uchile-robotics-graveyard/uchile_embedded/bender_head_arduino/README.md

Contenido del package
---------------------

[TOC]

# Software Interface

# Hardware Interface

# TODO LIST

## TODO list Hardware
* Implementar colores rgb en Arduino en lugar de en la interfaz de software
* Implementar comportamientos (funciones) determinados en Arduino
	+Agregar funciones "rainbow", "theaterChaseRainbow", etc.
	+Agregar "swap de servos"
* Probar con los brazos funcionando
* Solucionar problema con puertos seriales que usan los brazos
## TODO list Software
* Eliminar dependencias a directorio local al pasar a repo bender_head (rama feat-head\_arduino)
* Implementar nodo para control mediante joystick
* Implementar Archivos de configuracion para las caras
