uchile-robotics-graveyard/uchile_embedded/head_boards_http/design/num_leds_rgb.pdf

LED-> | 1 | 2 | 3 | 4 | 5 | 6 | 7 | 8 | 9 | 10 | 11 | 12 | 13 | 14 | 15 | 16
R | 95 | 92 | 89 | 86 | 83 | 80 | 77 | 74 | 71 | 68 | 65 | 62 | 59 | 56 | 53 | 50
G | 94 | 91 | 88 | 85 | 82 | 79 | 76 | 73 | 70 | 67 | 64 | 61 | 58 | 55 | 52 | 49
B | 93 | 90 | 87 | 84 | 81 | 78 | 75 | 72 | 69 | 66 | 63 | 60 | 57 | 54 | 51 | 48
LED-> 32 | 31 | 30 | 29 | 28 | 27 | 26 | 25 | 24 | 23 | 22 | 21 | 20 | 19 | 18 | 17
R | 2 | 5 | 8 | 11 | 14 | 17 | 20 | 23 | 26 | 29 | 32 | 35 | 38 | 41 | 44 | 47
G | 1 | 4 | 7 | 10 | 13 | 16 | 19 | 22 | 25 | 28 | 31 | 34 | 37 | 40 | 43 | 46
B | 0 | 3 | 6 | 9 | 12 | 15 | 18 | 21 | 24 | 27 | 30 | 33 | 36 | 39 | 42 | 45

*simetricos verticalmente

http://www.rapidtables.com/web/color/RGB_Color.htm
