uchile-robotics-graveyard/uchile_embedded/head_boards_http/design/mascara bender2.png

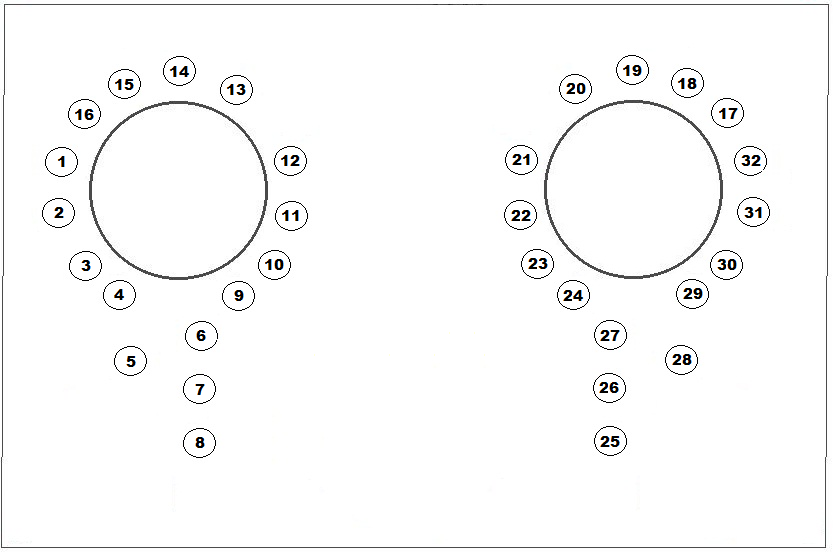
head_boards_http/design/mascara bender2.png
