uchile-robotics-graveyard/uchile_embedded/(list of files, cad)

Other CAD files:
head_led_driver/dist/default/production/head_led_driver.X.production.obj
head_led_driver/l.obj
