uchile-robotics-graveyard/uchile_embedded/head_boards_http/eagle/bender_head/servo_driver_board.brd

## EAGLE design head_boards_http/eagle/bender_head/servo_driver_board.brd (2016-02-21)

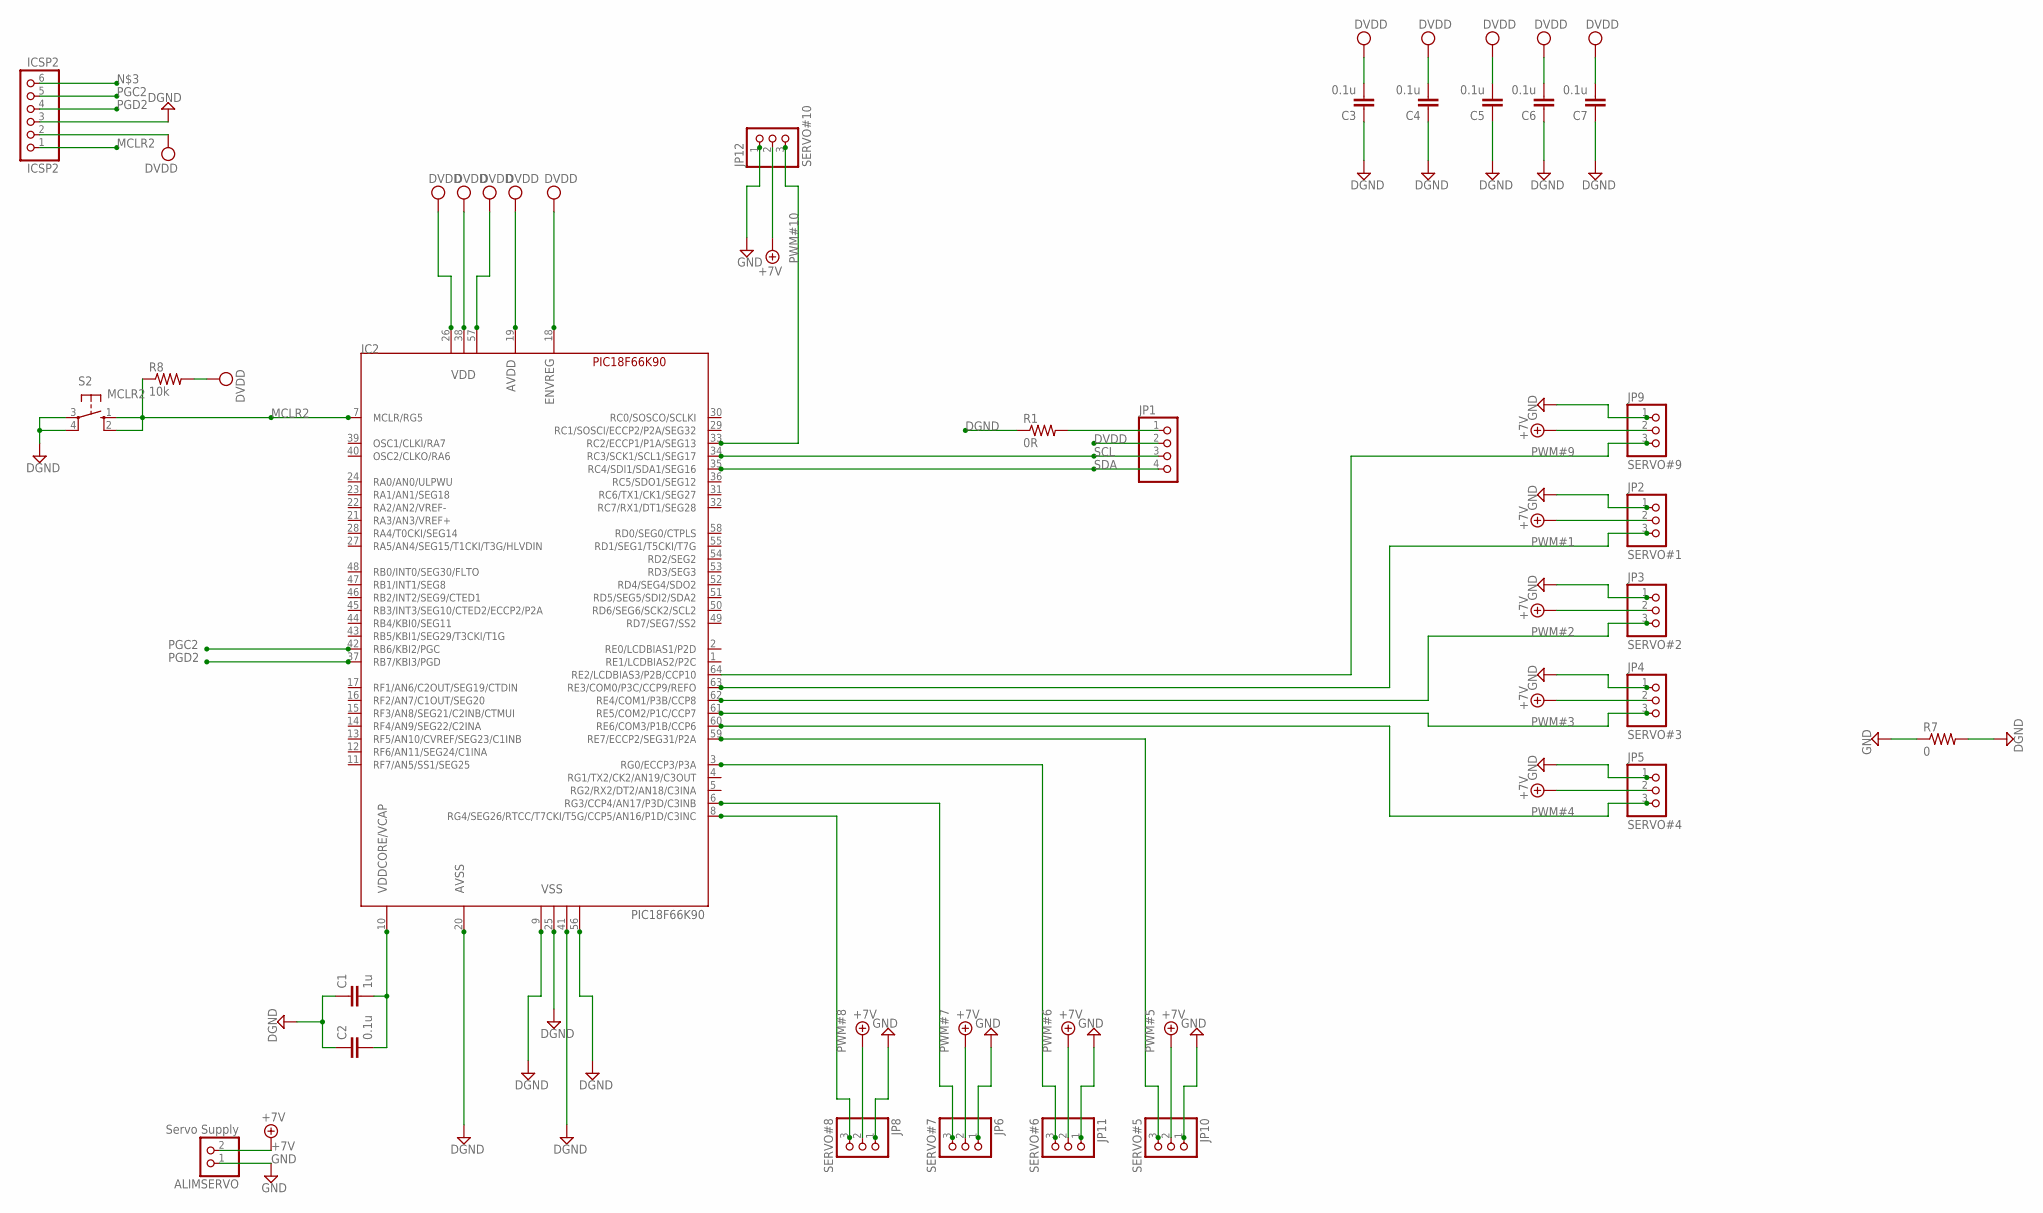
[picture p2: schematic servo_driver_board.sch]

Parts:
ALIMSERVO: Servo Supply; 1X02
C1: 1u; C0805
C2, C3, C4, C5, C6, C7: 0.1u; C0805
IC2: PIC18F66K90; TQFP64-10X10
ICSP2: ICSP2; 1X06
JP1: PINHD-1X4/90; 1X04/90
JP2: SERVO#1; 1X03
JP3: SERVO#2; 1X03
JP4: SERVO#3; 1X03
JP5: SERVO#4; 1X03
JP6: SERVO#7; 1X03
JP8: SERVO#8; 1X03
JP9: SERVO#9; 1X03
JP10: SERVO#5; 1X03
JP11: SERVO#6; 1X03
JP12: SERVO#10; 1X03
R1: 0R; R1206
R7: 0; R1206
R8: 10k; R1206
S2: MCLR2; B3F-10XX

Connections:
+7V: ALIMSERVO.2, JP2.2, JP3.2, JP4.2, JP5.2, JP6.2, JP8.2, JP9.2, JP10.2, JP11.2, JP12.2
DGND: C1.1, C2.1, C3.1, C4.1, C5.1, C6.1, C7.1, IC2.9 (VSS), IC2.20 (AVSS), IC2.25 (VSS), IC2.41 (VSS), IC2.56 (VSS), ICSP2.3, R1.1, R7.2, S2.3, S2.4 (P1)
DVDD: C3.2, C4.2, C5.2, C6.2, C7.2, IC2.18 (ENVREG), IC2.19 (AVDD), IC2.26 (VDD), IC2.38 (VDD), IC2.57 (VDD), ICSP2.2, JP1.2, R8.2
GND: ALIMSERVO.1, JP2.1, JP3.1, JP4.1, JP5.1, JP6.1, JP8.1, JP9.1, JP10.1, JP11.1, JP12.1, R7.1
MCLR2: IC2.7 (MCLR/RG5), ICSP2.1, R8.1, S2.1 (S), S2.2 (S1)
unnamed: JP1.1, R1.2
unnamed: C1.2, C2.2, IC2.10 (VDDCORE/VCAP)
PGC2: IC2.42 (RB6/KBI2/PGC), ICSP2.5
PGD2: IC2.37 (RB7/KBI3/PGD), ICSP2.4
PWM#1: IC2.63 (RE3/COM0/P3C/CCP9/REFO), JP2.3
PWM#2: IC2.62 (RE4/COM1/P3B/CCP8), JP3.3
PWM#3: IC2.61 (RE5/COM2/P1C/CCP7), JP4.3
PWM#4: IC2.60 (RE6/COM3/P1B/CCP6), JP5.3
PWM#5: IC2.59 (RE7/ECCP2/SEG31/P2A), JP10.3
PWM#6: IC2.3 (RG0/ECCP3/P3A), JP11.3
PWM#7: IC2.6 (RG3/CCP4/AN17/P3D/C3INB), JP6.3
PWM#8: IC2.8 (RG4/SEG26/RTCC/T7CKI/T5G/CCP5/AN16/P1D/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), JP8.3
PWM#9: IC2.64 (RE2/LCDBIAS3/P2B/CCP10), JP9.3
PWM#10: IC2.33 (RC2/ECCP1/P1A/SEG13), JP12.3
SCL: IC2.34 (RC3/SCK1/SCL1/SEG17), JP1.3
SDA: IC2.35 (RC4/SDI1/SDA1/SEG16), JP1.4

Notes on the sheet:
PWM#1
PWM#2
PWM#3
PWM#4
PWM#7
PWM#8
PWM#9
PWM#5
PWM#6
PWM#10

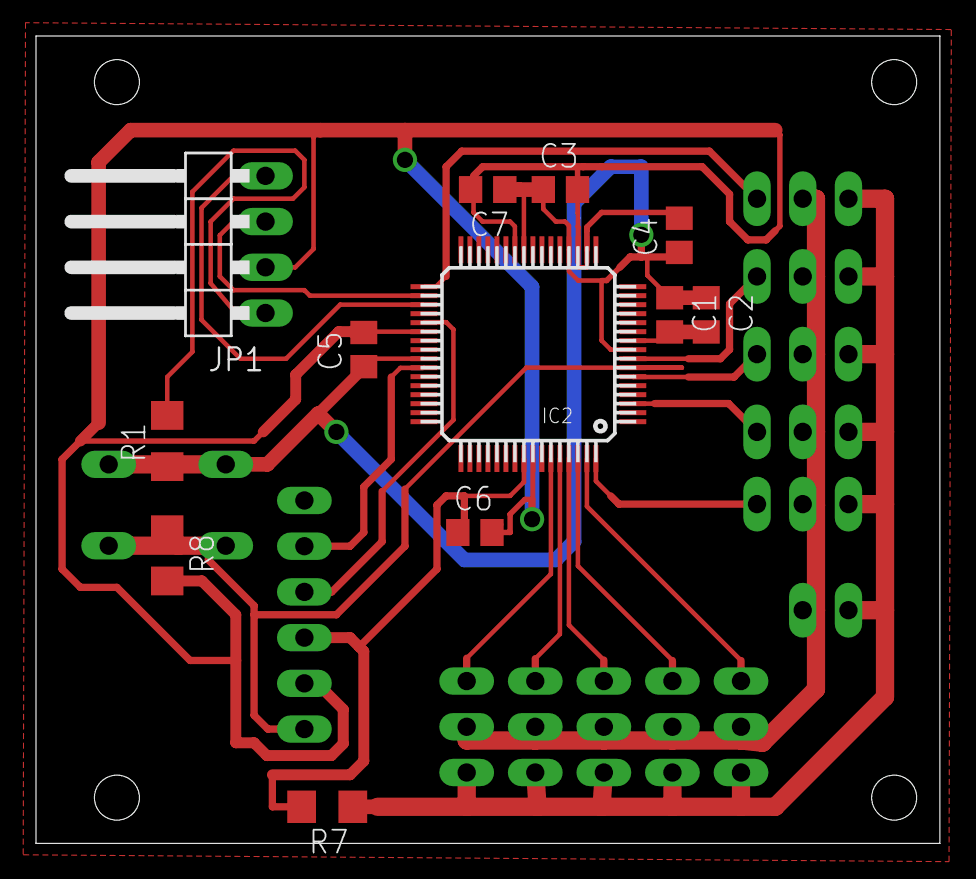
[picture p3: board servo_driver_board.brd from above]

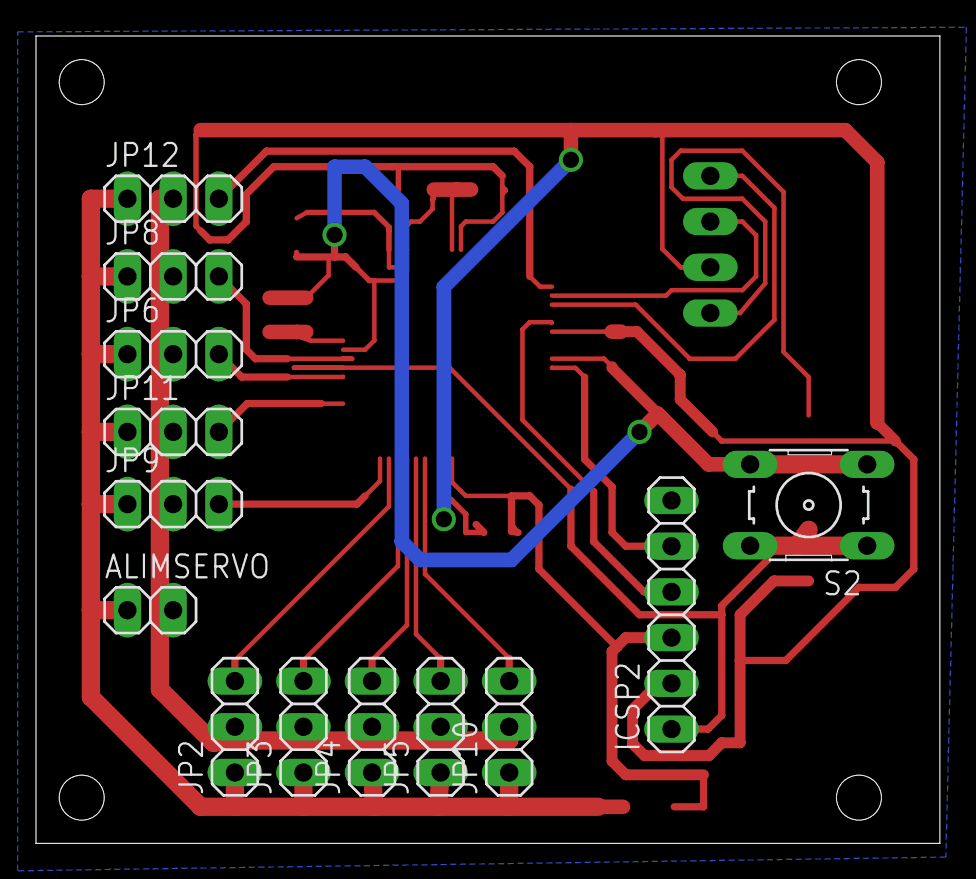
[picture p4: board servo_driver_board.brd from below]

Board: 2 copper layers, 50.2 x 44.9 mm, 25 parts (13 on the bottom side), 21 nets.
