uchile-robotics-graveyard/uchile_embedded/head_boards_http/eagle/bender_head/bender_head.brd

## EAGLE design head_boards_http/eagle/bender_head/bender_head.brd (2016-02-21)

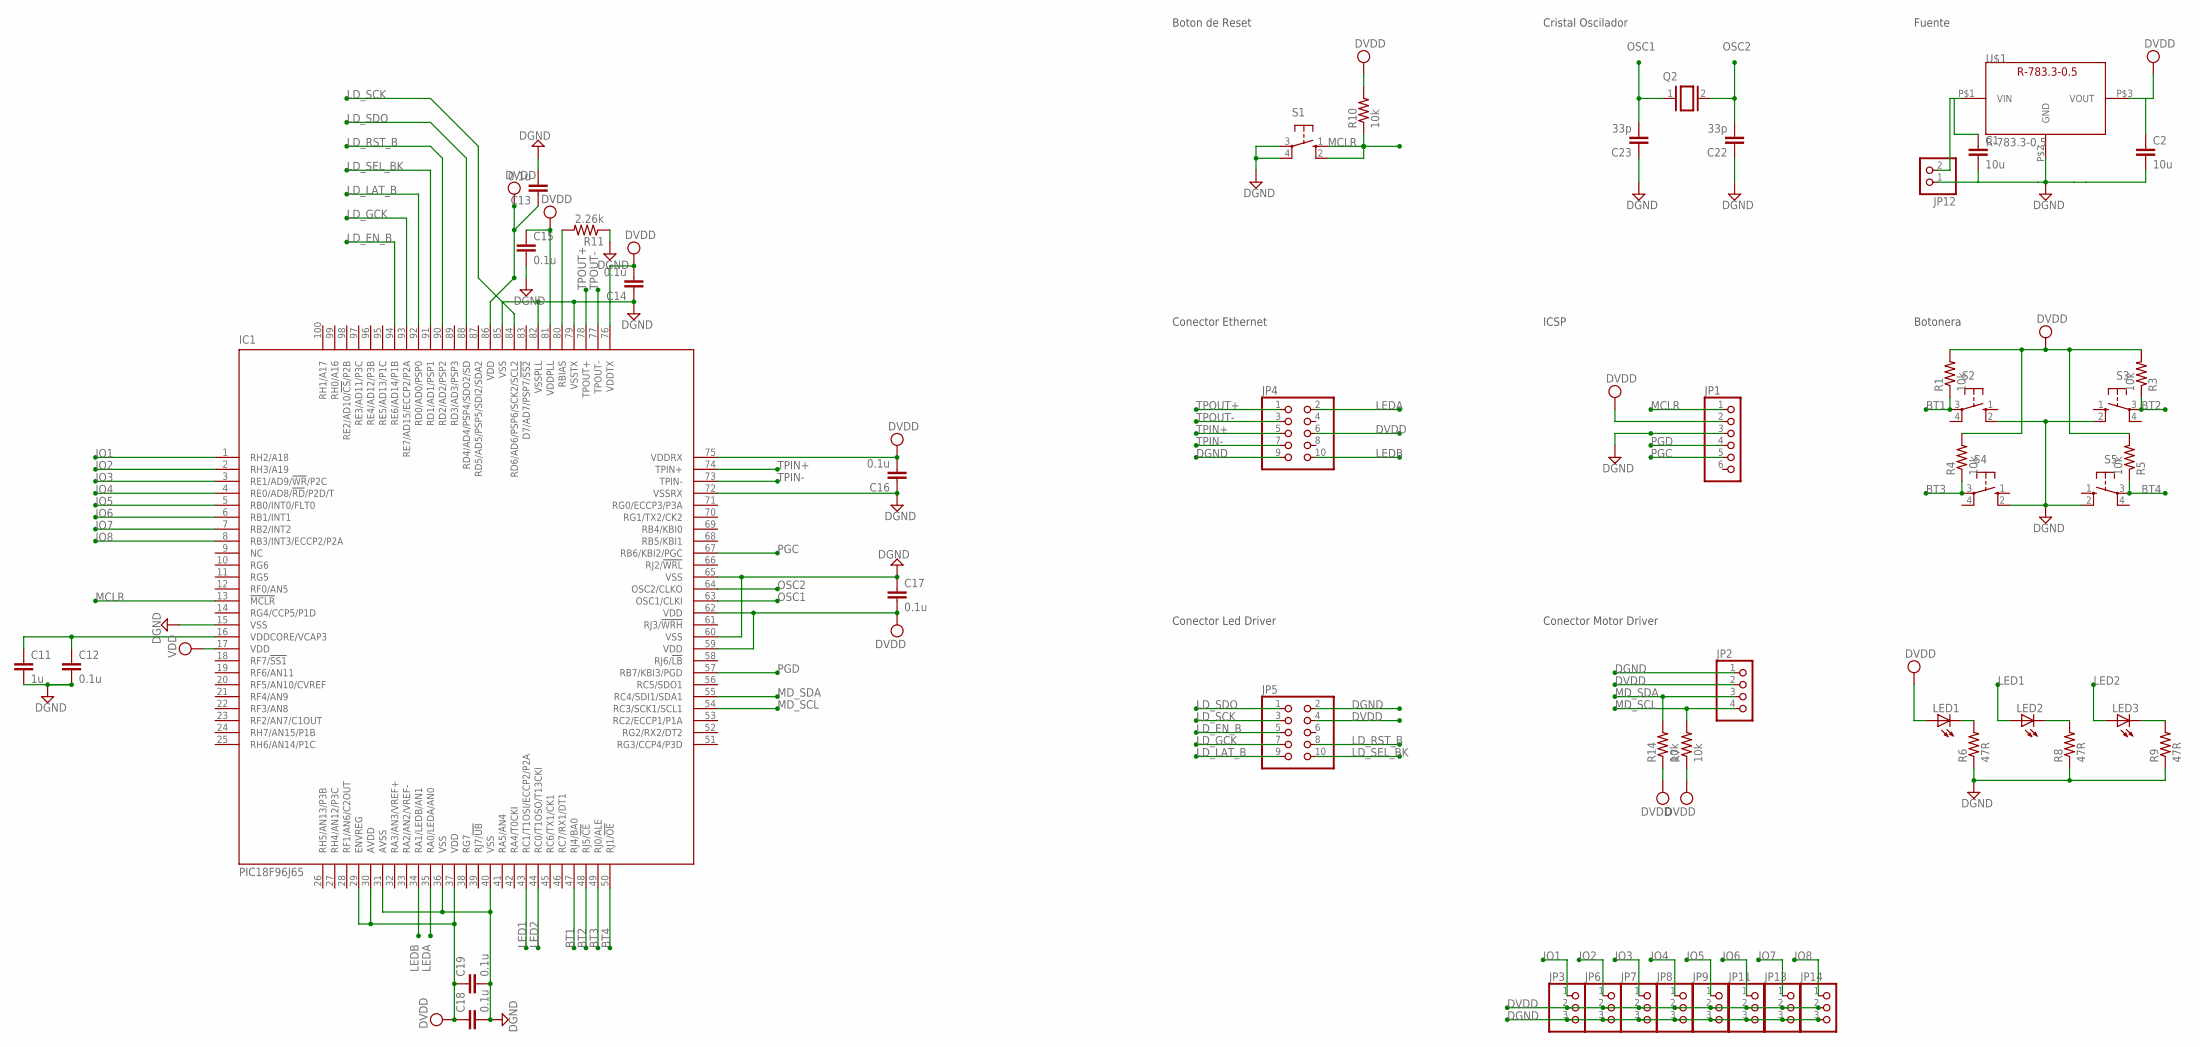
[picture p5: schematic bender_head.sch]

Parts:
C1, C2: 10u; C1206
C11: 1u; C1206
C12, C13, C14, C15, C16, C17, C18, C19: 0.1u; C0805
C22, C23: 33p; C1206
IC1: PIC18F96J65; TQFP100
JP1: PINHD-1X6; 1X06
JP2: PINHD-1X4/90; 1X04/90
JP3, JP6, JP7, JP8, JP9, JP11, JP13, JP14: PINHD-1X3; 1X03
JP4, JP5: PINHD-2X5/90; 2X05/90
JP12: PINHD-1X2/90; 1X02/90
LED1, LED2, LED3: LEDSML0805; SML0805
Q2: XTAL/S; QS
R1, R3, R4, R5, R7, R10, R14: 10k; R1206
R6: 47R; M0805
R8, R9: 47R; M1206
R11: 2.26k; R1206
S1, S2, S3, S4, S5: 10-XX; B3F-10XX
U$1: R-783.3-0.5

Connections:
BT1: IC1.47 (RJ4/BA0), R1.1, S2.3
BT2: IC1.48 (RJ5/!CE), R3.1, S3.3
BT3: IC1.49 (RJ0/ALE), R4.1, S4.3
BT4: IC1.50 (RJ1/!OE), R5.1, S5.3
DGND: C1.2, C2.2, C11.2, C12.2, C13.2, C14.1, C15.2, C16.1, C17.1, C18.2, C19.2, C22.1, C23.1, IC1.15 (VSS), IC1.31 (AVSS), IC1.36 (VSS), IC1.40 (VSS), IC1.60 (VSS), IC1.65 (VSS), IC1.72 (VSSRX), IC1.79 (VSSTX), IC1.82 (VSSPLL), IC1.85 (VSS), JP1.3, JP2.1, JP3.3, JP4.9, JP5.2, JP6.3, JP7.3, JP8.3, JP9.3, JP11.3, JP12.1, JP13.3, JP14.3, R6.1, R8.1, R9.1, R11.1, S1.3, S1.4 (P1), S2.2 (S1), S3.2 (S1), S4.2 (S1), S5.2 (S1), U$1.P$2 (GND)
DVDD: C2.1, C13.1, C14.2, C15.1, C16.2, C17.2, C18.1, C19.1, IC1.17 (VDD), IC1.29 (ENVREG), IC1.30 (AVDD), IC1.37 (VDD), IC1.59 (VDD), IC1.62 (VDD), IC1.75 (VDDRX), IC1.76 (VDDTX), IC1.81 (VDDPLL), IC1.86 (VDD), JP1.2, JP2.2, JP3.2, JP4.6, JP5.4, JP6.2, JP7.2, JP8.2, JP9.2, JP11.2, JP13.2, JP14.2, LED1.A, R1.2, R3.2, R4.2, R5.2, R7.1, R10.2, R14.1, U$1.P$3 (VOUT)
IO1: IC1.1 (RH2/A18), JP3.1
IO2: IC1.2 (RH3/A19), JP6.1
IO3: IC1.3 (RE1/AD9/!WR!/P2C), JP7.1
IO4: IC1.4 (RE0/AD8/!RD!/P2D/T), JP8.1
IO5: IC1.5 (RB0/INT0/FLT0), JP9.1
IO6: IC1.6 (RB1/INT1), JP11.1
IO7: IC1.7 (RB2/INT2), JP13.1
IO8: IC1.8 (RB3/INT3/ECCP2/P2A), JP14.1
LD_EN_B: IC1.94 (RE6/AD14/P1B), JP5.5
LD_GCK: IC1.93 (RE7/AD15/ECCP2/P2A), JP5.7
LD_LAT_B: IC1.92 (RD0/AD0/PSP0), JP5.9
LD_RST_B: IC1.90 (RD2/AD2/PSP2), JP5.8
LD_SCK: IC1.84 (RD6/AD6/PSP6/SCK2/SCL2), JP5.3
LD_SDO: IC1.88 (RD4/AD4/PSP4/SDO2/SD), JP5.1
LD_SEL_BK: IC1.91 (RD1/AD1/PSP1), JP5.10
LED1: IC1.43 (RC1/T1OSI/ECCP2/P2A), LED2.A
LED2: IC1.44 (RC0/T1OSO/T13CKI), LED3.A
LEDA: IC1.35 (RA0/LEDA/AN0), JP4.2
LEDB: IC1.34 (RA1/LEDB/AN1), JP4.10
MCLR: IC1.13 (!MCLR), JP1.1, R10.1, S1.1 (S), S1.2 (S1)
MD_SCL: IC1.54 (RC3/SCK1/SCL1), JP2.4, R7.2
MD_SDA: IC1.55 (RC4/SDI1/SDA1), JP2.3, R14.2
unnamed: LED1.C, R6.2
unnamed: LED2.C, R8.2
unnamed: LED3.C, R9.2
unnamed: C11.1, C12.1, IC1.16 (VDDCORE/VCAP3)
unnamed: IC1.80 (RBIAS), R11.2
OSC1: C23.2, IC1.63 (OSC1/CLKI), Q2.1
OSC2: C22.2, IC1.64 (OSC2/CLKO), Q2.2
PGC: IC1.67 (RB6/KBI2/PGC), JP1.5
PGD: IC1.57 (RB7/KBI3/PGD), JP1.4
TPIN+: IC1.74 (TPIN+), JP4.5
TPIN-: IC1.73 (TPIN-), JP4.7
TPOUT+: IC1.78 (TPOUT+), JP4.1
TPOUT-: IC1.77 (TPOUT-), JP4.3
VIN: C1.1, JP12.2, U$1.P$1 (VIN)

Notes on the sheet:
Conector Ethernet
Cristal Oscilador
Boton de Reset
Conector Led Driver
Conector Motor Driver
ICSP
Botonera
Fuente

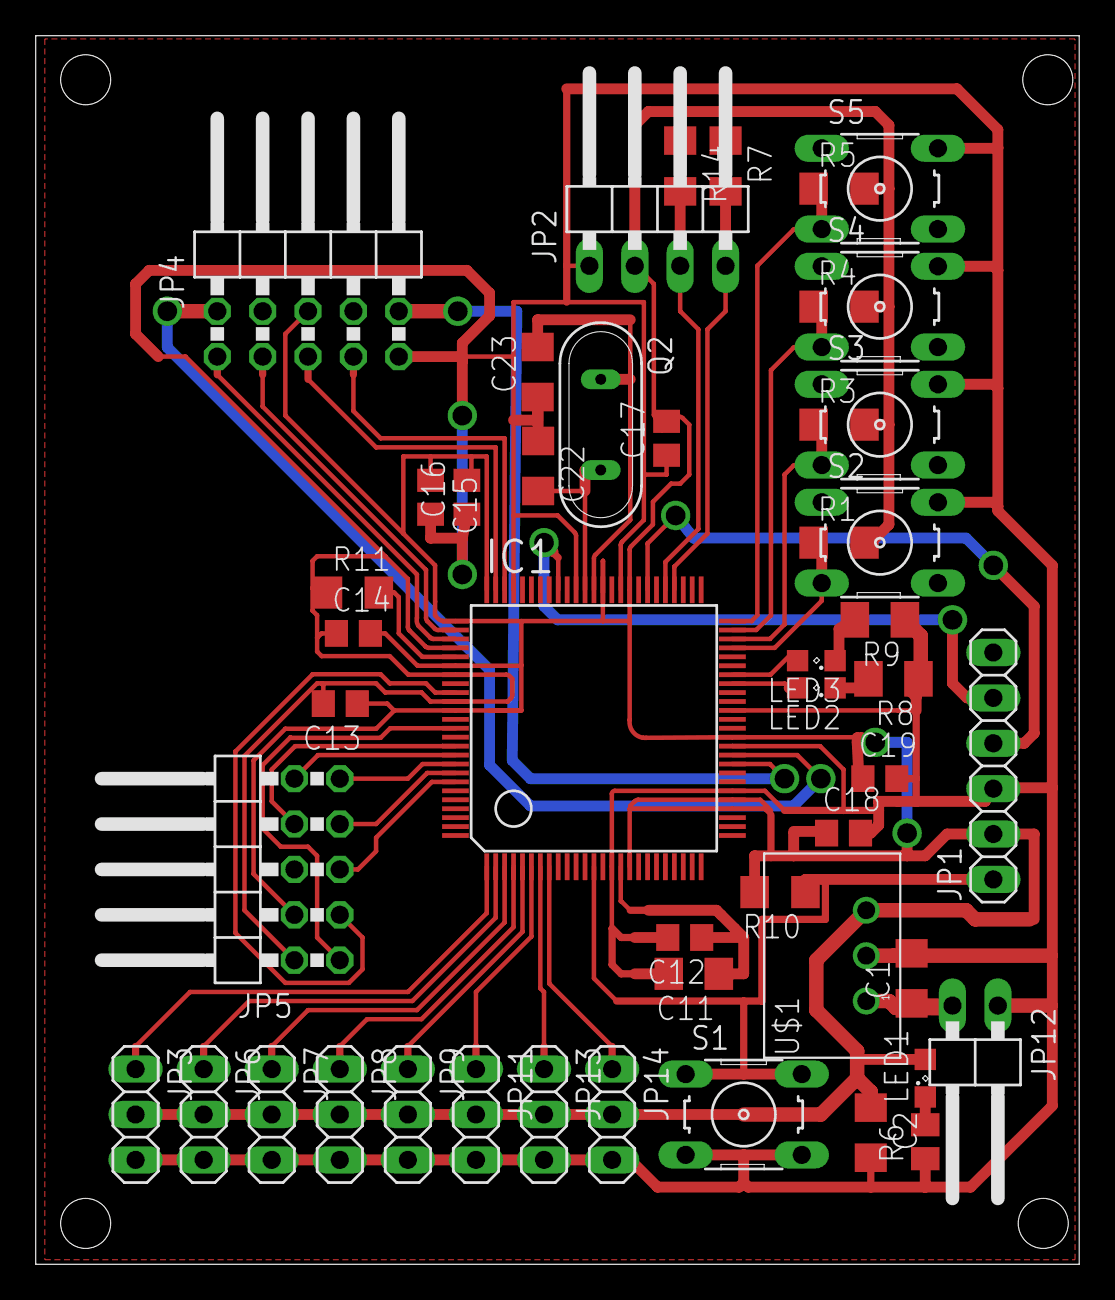
[picture p6: board bender_head.brd from above]

Board: 2 copper layers, 58.4 x 68.8 mm, 48 parts (0 on the bottom side), 42 nets.
