uchile-robotics-graveyard/uchile_embedded/head_boards_http/eagle/bender_head/ethernet_board.brd

## EAGLE design head_boards_http/eagle/bender_head/ethernet_board.brd (2016-02-21)

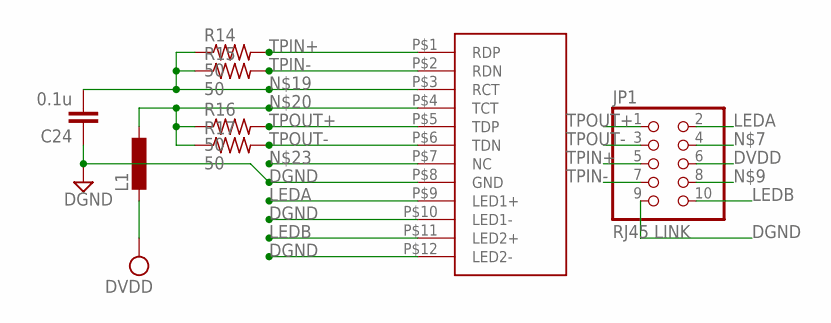
[picture p7: schematic ethernet_board.sch]

Parts:
C24: 0.1u; C0805
JP1: RJ45 LINK; 2X05/90
L1: L-EU0207/10; 0207/10
R14, R15, R16, R17: 50; R1206
U$5: RJ45; TYCO-RJ45

Connections:
DGND: C24.1, JP1.9, U$5.P$8 (GND), U$5.P$10 (LED1-), U$5.P$12 (LED2-)
DVDD: JP1.6, L1.2
LEDA: JP1.2, U$5.P$9 (LED1+)
LEDB: JP1.10, U$5.P$11 (LED2+)
unnamed: C24.2, R14.1, R15.1, U$5.P$3 (RCT)
unnamed: L1.1, R16.1, R17.1, U$5.P$4 (TCT)
TPIN+: JP1.5, R14.2, U$5.P$1 (RDP)
TPIN-: JP1.7, R15.2, U$5.P$2 (RDN)
TPOUT+: JP1.1, R16.2, U$5.P$5 (TDP)
TPOUT-: JP1.3, R17.2, U$5.P$6 (TDN)

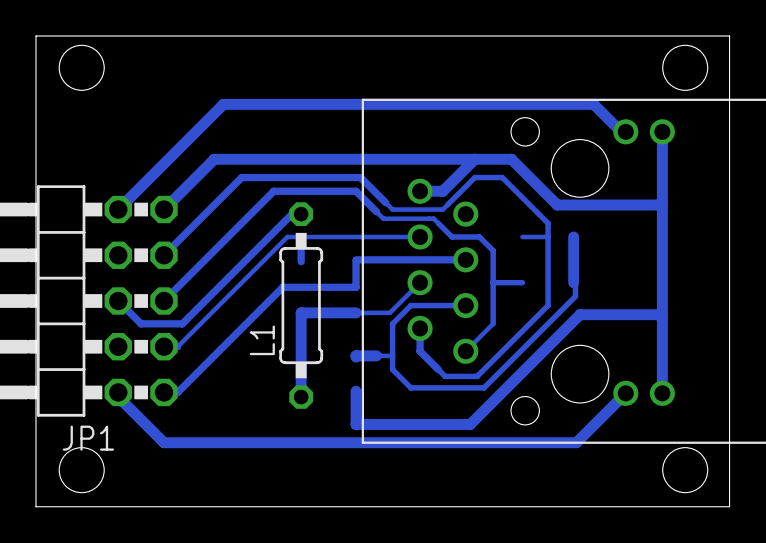
[picture p8: board ethernet_board.brd from above]

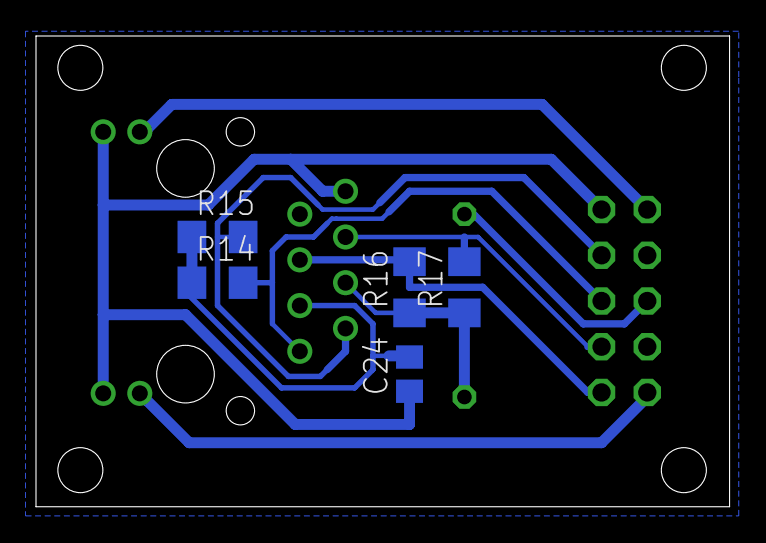
[picture p9: board ethernet_board.brd from below]

Board: 2 copper layers, 38.5 x 26.2 mm, 8 parts (5 on the bottom side), 10 nets.
