uchile-robotics-graveyard/uchile_embedded/bender_head_arduino/arduino/head_driver_fix/head_driver_fix.ino

#include <SerialDXL.h>
#include <Servo.h>
#include <Adafruit_NeoPixel.h>
#ifdef __AVR__
  #include <avr/power.h>
#endif

// SERVO DXL basic config
#define HEAD_MODEL 100
#define HEAD_FIRMWARE 100
#define HEAD_MMAP_SIZE 4

// Number of servos in the array
#define num_servos 5

// Pin numbers on Arduino Mega to control the servo devices
#define pin_dir 6
#define pin_reset 7
#define pin_servo0 8
#define pin_servo1 9
#define pin_servo2 10
#define pin_servo3 11
#define pin_servo4 12

// Pin numbers on Arduino Mega to control the LED devices
#define data_led_pin1 3
#define data_led_pin2 2
#define pixelNumber 16

/**
 * @brief Head control using DXL communication protocol
 * @details Head control using Dynamixel communication protocol over RS485.
 * This implementation uses 4 uint8_t variables to control state of 5 servo motors and 2 NeoPixel arrays. 
 * 
 * @param dir_pin Toggle communication pin.
 * @param reset_pin Pin for reset device
 * @param servo_pin SERVO pin.
 */
class HeadDXL: public DeviceDXL<HEAD_MODEL, HEAD_FIRMWARE>
{
  public:
	HeadDXL(uint8_t dir_pin, uint8_t reset_pin, uint8_t numServos, uint8_t servos_pins[]):
    DeviceDXL(HEAD_MMAP_SIZE), // Call parent constructor
    dir_pin_(dir_pin),    // Direction pin for RS485
    reset_pin_(reset_pin), // Reset pin
	  numServos_(numServos), // numero de servos
	  //servos_pins_(servos_pins),    // SERVOS pins
	  //servos_(servos),			// Puntero a objeto Servo
    servo_select_command_(MMap::Access::RW, MMap::Storage::RAM), // Servo command 1
    servo_pos_command_(MMap::Access::RW, MMap::Storage::RAM), // Servo command 2
	  led_select_command_(MMap::Access::RW, MMap::Storage::RAM), // array LEDs command 1
	  led_color_command_(MMap::Access::RW, MMap::Storage::RAM) // array LEDs command 2
    //led_update_color_command_(LED_UPDATE_COLOR_COMMAND, MMap::Access::RW, 0U, 1U, 0U) // array LEDs command 3
    {
      // Config pins
      pinMode(dir_pin_, OUTPUT);
      pinMode(reset_pin_, OUTPUT);
  	  for(uint8_t i=0;i<numServos_;i++)
  	  {
        pinMode(servos_pins[i], OUTPUT);
  	  }
    }

    void init(uint8_t servos_pins[], Servo servos[], Adafruit_NeoPixel LEDs[])
    {
      DEBUG_PRINTLN("INIT");
      /*
       * Register variables
       */
      DeviceDXL::init();
      mmap_.registerVariable(&servo_select_command_);
      mmap_.registerVariable(&servo_pos_command_);
      mmap_.registerVariable(&led_select_command_);
      mmap_.registerVariable(&led_color_command_);
      //mmap_.registerVariable(&led_update_color_command_);
      mmap_.init();
      
      /*
       * Load default values
       */
      DEBUG_PRINTLN("Load default");
      mmap_.load(); // Load values from EEPROM
      DEBUG_PRINT("data: ");DEBUG_PRINTLN(servo_select_command_.data);
      DEBUG_PRINT("data: ");DEBUG_PRINTLN(servo_pos_command_.data);
      DEBUG_PRINT("data: ");DEBUG_PRINTLN(led_select_command_.data);
      DEBUG_PRINT("data: ");DEBUG_PRINTLN(led_color_command_.data);
      // DEBUG_PRINT("data: ");DEBUG_PRINTLN(led_update_color_command_.data);
      
      /*
       * Read sensor data
       * e.g. Use ADC, check buttons, etc.
       */

  	  /*
  	   * Attach the Servo's variables to the servos_pins
  	   */
  	  for(uint8_t i=0;i<numServos_;i++)
  	  {
  	  	servos[i].attach(servos_pins[i]);
  	  }
        // Settings for LED arrays
  	  // This is for Trinket 5V 16MHz, you can remove these three lines if you are not using a Trinket
  	  #if defined (__AVR_ATtiny85__)
  		if (F_CPU == 16000000) clock_prescale_set(clock_div_1);
  	  #endif
  	  // End of trinket special code
      for(uint8_t i=0;i<2;i++)
  	  {
  	  	LEDs[i].begin();
  	    LEDs[i].setBrightness(5);
  	    LEDs[i].show(); // Initialize all pixels to 'off'
  	  }
    }
  
  	void moveServoTo(Servo *servo, uint8_t pos)
  	{
  		servo->write(pos);
  		delay(2);
  	}
 
  	void setPixelsTo(Adafruit_NeoPixel *LEDs_ring1, Adafruit_NeoPixel *LEDs_ring2, uint8_t R_colors[], uint8_t G_colors[], uint8_t B_colors[], uint8_t size)
  	{
  		//Serial.println(sizeof(pixelPositions));
  		for(uint8_t i=0; i<size; i++)
  		{
  			LEDs_ring1->setPixelColor(i, R_colors[i], G_colors[i], B_colors[i]);
  			LEDs_ring2->setPixelColor(i, R_colors[i+16], G_colors[i+16], B_colors[i+16]);
  		}
  		LEDs_ring1->show();
  		delay(5);
  		LEDs_ring2->show();
  		delay(5);
  		DEBUG_PRINTLN("LEDs_rings->show()");
  	}
 
  	uint8_t colorLevel(uint8_t level_code)
  	{
  		if(level_code==0) return 0;	//min component color value
  		else if(level_code==1) return 102;
  		else if(level_code==2) return 153;
  		else if(level_code==3) return 255;	//max component color value
  	}
 
  	uint8_t getRColor(uint8_t rgb_code){ return colorLevel((rgb_code & 0b00110000)>>4);}
  	uint8_t getGColor(uint8_t rgb_code){ return colorLevel((rgb_code & 0b00001100)>>2);}
  	uint8_t getBColor(uint8_t rgb_code){ return colorLevel((rgb_code & 0b00000011)>>0);}

  	//void updateServos(Servo servos[], uint8_t servo_select, uint8_t servo_pos, uint8_t command)
  	void updateServos(Servo servos[])
  	{
  		if (servo_select_command_.data == 5)	//when both values updated, change state
  		{
  			if (servo_select_ == 0) moveServoTo(&servos[0], servo_pos_);
  			else if (servo_select_ == 1) moveServoTo(&servos[1], servo_pos_);
  			else if (servo_select_ == 2) moveServoTo(&servos[2], servo_pos_);
  			else if (servo_select_ == 3) moveServoTo(&servos[3], servo_pos_);
  			else if (servo_select_ == 4) moveServoTo(&servos[4], servo_pos_);
  		}
  		else	//update both values, selct and position
  		{
  			servo_select_ = servo_select_command_.data;
  			servo_pos_ = servo_pos_command_.data;
  		}
  	}
   
  	void updateLEDs(Adafruit_NeoPixel LEDs[])
  	{
    		if (led_select_command_.data == 0xFE){	//array of colors updated, ready to show
    			setPixelsTo(&LEDs[0], &LEDs[1], R_colors_, G_colors_, B_colors_, 16); //show colors in LEDs
    			//DEBUG_PRINTLN("show command (0xFE)");
    		}
    		else if (led_select_command_.data == 0xFD){	//updating array of colors
    			R_colors_[led_to_change_] = getRColor(new_color_code_);
    			G_colors_[led_to_change_] = getGColor(new_color_code_);
    			B_colors_[led_to_change_] = getBColor(new_color_code_);
    			/*DEBUG_PRINT("new_color_code_ = ");DEBUG_PRINTLN(new_color_code_);
    			DEBUG_PRINT("r_color = ");DEBUG_PRINTLN(getRColor(new_color_code_));
    			DEBUG_PRINT("g_color = ");DEBUG_PRINTLN(getGColor(new_color_code_));
    			DEBUG_PRINT("b_color = ");DEBUG_PRINTLN(getBColor(new_color_code_));*/
    			//DEBUG_PRINTLN("change color command (0xFD)");
    		}
    		/*else if (led_select_command_.data == 0xFC){	//Leds commands are not used in this case
    			//DEBUG_PRINTLN("Led command non used");
    		}*/
    		else if (led_select_command_.data != 0xFC) //update last led number and color received
    		{
    			led_to_change_ = led_select_command_.data;
    			new_color_code_ = led_color_command_.data;
    			//DEBUG_PRINTLN("variables updated");
    		}
  	  }
   
    void update(Servo servos[], Adafruit_NeoPixel LEDs[])
    {
  		//DEBUG_PRINTLN("UPDATE");
  		updateServos(servos);
  		updateLEDs(LEDs);
    }
    
    void SetDefaulState(Servo servos[], Adafruit_NeoPixel LEDs[])
    {
    	//Default colors
  		uint8_t R_colors_default[32] = {0,0,0,153,153,153,0,0,0,0,153,0,0,0,0,0,0,0,0,153,153,153,0,0,0,0,153,0,0,0,0,0};
  		uint8_t G_colors_default[32] = {0,0,0,0,0,0,0,0,0,0,0,0,153,153,153,153,0,0,0,0,0,0,0,0,0,0,0,0,153,153,153,153};
  		uint8_t B_colors_default[32] = {153,153,153,0,0,0,0,0,0,153,0,153,0,0,0,0,153,153,153,0,0,0,0,0,0,153,0,153,0,0,0,0};
  		
      moveServoTo(&servos[0], 50);
  		moveServoTo(&servos[1], 120);
  		moveServoTo(&servos[2], 100);
  		moveServoTo(&servos[3], 120);
  		moveServoTo(&servos[4], 100);
  		setPixelsTo(&LEDs[0], &LEDs[1], R_colors_default, G_colors_default, B_colors_default, 16); //show colors in LEDs
    }

    inline bool onReset()
    {
      DEBUG_PRINTLN("ON RESET");
      return digitalRead(reset_pin_) == HIGH ? true : false;
    }

    inline void setTX()
    {
      digitalWrite(dir_pin_,HIGH);
    }

    inline void setRX()
    {
      digitalWrite(dir_pin_,LOW);
    }

  private:
    const uint8_t dir_pin_; // Toggle communication direction pin
    const uint8_t reset_pin_; // Reset pin
	  const uint8_t numServos_; // Numero de servos
    //const uint8_t servos_pins_[5]; // SERVOs pins
	  //Servo *servos_[5]; //puntero a objeto Servo
    
    // SERVOs variables    
    MMap::Variable<UInt8, UInt8::type, 0U, 6U, 0U> servo_select_command_;
    MMap::Variable<UInt8, UInt8::type, 0U, 180U, 0U> servo_pos_command_;

    // LEDs variables
    MMap::Variable<UInt8, UInt8::type, 0U, 254U, 0U> led_select_command_;
    MMap::Variable<UInt8, UInt8::type, 0U, 254U, 0U> led_color_command_;
    	
  	//LEDs colors
  	uint8_t R_colors_[32] = {0,0,0,0,0,0,0,0,0,0,0,0,0,0,0,0,0,0,0,0,0,0,0,0,0,0,0,0,0,0,0,0};
  	uint8_t G_colors_[32] = {0,0,0,0,0,0,0,0,0,0,0,0,0,0,0,0,0,0,0,0,0,0,0,0,0,0,0,0,0,0,0,0};
  	uint8_t B_colors_[32] = {0,0,0,0,0,0,0,0,0,0,0,0,0,0,0,0,0,0,0,0,0,0,0,0,0,0,0,0,0,0,0,0};
  	uint8_t led_to_change_ = 0;
  	uint8_t new_color_code_ = 0;
	
  	//servos
  	uint8_t servo_select_ = 0;
  	uint8_t servo_pos_ = 0;
};

//Objetos para posicionar los servos (PWM)
Servo servo0;
Servo servo1;
Servo servo2;
Servo servo3;
Servo servo4;

Servo servos[]={servo0, servo1, servo2, servo3, servo4};
uint8_t servos_pins[] = {pin_servo0, pin_servo1, pin_servo2, pin_servo3, pin_servo4};

//Objetos para manejar los LEDs
Adafruit_NeoPixel strip1 = Adafruit_NeoPixel(pixelNumber, data_led_pin1, NEO_GRB + NEO_KHZ800);
Adafruit_NeoPixel strip2 = Adafruit_NeoPixel(pixelNumber, data_led_pin2, NEO_GRB + NEO_KHZ800);

Adafruit_NeoPixel LEDs[] = {strip1, strip2};

//General device
HeadDXL head_dxl(pin_dir, pin_reset, num_servos, servos_pins);
SerialDXL<HeadDXL> serialDxl;

void setup() {
  //Serial port for debug
  Serial.begin(115200);
  delay(50);
  
  head_dxl.init(servos_pins, servos, LEDs);
  head_dxl.SetDefaulState(servos, LEDs);
  head_dxl.reset();
  head_dxl.mmap_.serialize();

  // Init serial communication using Dynamixel format
  serialDxl.init(&Serial3 , &head_dxl);
}

void loop() {
  // Update msg buffer
  while (Serial3.available())
    serialDxl.process(Serial3.read());

  head_dxl.mmap_.deserialize();
  head_dxl.update(servos, LEDs);
  head_dxl.mmap_.serialize();
}
