uchile-robotics-graveyard/uchile_embedded/head_boards_http/MPLABXProjects/bender_head/servo_board/config.h

// PIC18F66K90 Configuration Bit Settings

// 'C' source line config statements

//#include <xc.h>

// #pragma config statements should precede project file includes.
// Use project enums instead of #define for ON and OFF.

// CONFIG1L
#pragma config RETEN = ON       // VREG Sleep Enable bit (Enabled)
#pragma config INTOSCSEL = HIGH // LF-INTOSC Low-power Enable bit (LF-INTOSC in High-power mode during Sleep)
#pragma config SOSCSEL = HIGH   // SOSC Power Selection and mode Configuration bits (High Power SOSC circuit selected)
#pragma config XINST = ON       // Extended Instruction Set (Enabled)

// CONFIG1H
#pragma config FOSC = INTIO2    // Oscillator (Internal RC oscillator)
#pragma config PLLCFG = OFF     // PLL x4 Enable bit (Disabled)
#pragma config FCMEN = OFF      // Fail-Safe Clock Monitor (Disabled)
#pragma config IESO = OFF       // Internal External Oscillator Switch Over Mode (Disabled)

// CONFIG2L
#pragma config PWRTEN = OFF     // Power Up Timer (Disabled)
#pragma config BOREN = OFF      // Brown Out Detect (Disabled in hardware, SBOREN disabled)
#pragma config BORV = 3         // Brown-out Reset Voltage bits (1.8V)
#pragma config BORPWR = ZPBORMV // BORMV Power level (ZPBORMV instead of BORMV is selected)

// CONFIG2H
#pragma config WDTEN = OFF      // Watchdog Timer (WDT disabled in hardware; SWDTEN bit disabled)
#pragma config WDTPS = 1048576  // Watchdog Postscaler (1:1048576)

// CONFIG3L
#pragma config RTCOSC = SOSCREF // RTCC Clock Select (RTCC uses SOSC)

// CONFIG3H
//#pragma config CCP2MX = ON   // CCP2 Mux (RE7)
#pragma config MSSPMSK = MSK7   // MSSP address masking (7 Bit address masking mode)
#pragma config MCLRE = ON       // Master Clear Enable (MCLR Enabled, RG5 Disabled)

// CONFIG4L
#pragma config STVREN = ON      // Stack Overflow Reset (Enabled)
#pragma config BBSIZ = BB2K     // Boot Block Size (2K word Boot Block size)

// CONFIG5L
#pragma config CP0 = OFF        // Code Protect 00800-03FFF (Disabled)
#pragma config CP1 = OFF        // Code Protect 04000-07FFF (Disabled)
#pragma config CP2 = OFF        // Code Protect 08000-0BFFF (Disabled)
#pragma config CP3 = OFF        // Code Protect 0C000-0FFFF (Disabled)

// CONFIG5H
#pragma config CPB = OFF        // Code Protect Boot (Disabled)
#pragma config CPD = OFF        // Data EE Read Protect (Disabled)

// CONFIG6L
#pragma config WRT0 = OFF       // Table Write Protect 00800-03FFF (Disabled)
#pragma config WRT1 = OFF       // Table Write Protect 04000-07FFF (Disabled)
#pragma config WRT2 = OFF       // Table Write Protect 08000-0BFFF (Disabled)
#pragma config WRT3 = OFF       // Table Write Protect 0C000-0FFFF (Disabled)

// CONFIG6H
#pragma config WRTC = OFF       // Config. Write Protect (Disabled)
#pragma config WRTB = OFF       // Table Write Protect Boot (Disabled)
#pragma config WRTD = OFF       // Data EE Write Protect (Disabled)

// CONFIG7L
#pragma config EBRT0 = OFF      // Table Read Protect 00800-03FFF (Disabled)
#pragma config EBRT1 = OFF      // Table Read Protect 04000-07FFF (Disabled)
#pragma config EBRT2 = OFF      // Table Read Protect 08000-0BFFF (Disabled)
#pragma config EBRT3 = OFF      // Table Read Protect 0C000-0FFFF (Disabled)

// CONFIG7H
#pragma config EBRTB = OFF      // Table Read Protect Boot (Disabled)
