uchile-robotics-graveyard/uchile_embedded/head_boards_http/MPLABXProjects/ejemplos/emociones/EmotionBender.cpp

#include <cstdlib>
#include <iostream>
#include <string.h>
#include <sys/types.h>
#include <sys/socket.h>
#include <netdb.h>
#include <unistd.h>
#include <errno.h>
#include "EmotionBender.h"
#define MAXHOSTNAME 256
using namespace std;

//Auxiliary functions
void frame(char * array, int delay)
{
	//for(int i=96;i<MSGSIZE;i++)
	//array[i]=128;
	sendBuf(array,MSGSIZE);
	sleep(delay);
	//cout << "frame sent" << endl;
}
void resetArray(char * array)
{
	for(int j=0;j<MSGSIZE;j++)
	{
		array[j]=0;       //leds
		if(j > 95)
			array[j]=128; //motors
	}
}
void testLeds1()
{
	char face[MSGSIZE];
	resetArray(face);
	int j=0;
	for(int i=4; i>0;i--)
	{
		j=++j%3;
		for(int i=0;i<96;i++)
		{
			if(i%3==j)
				face[i]=255;
			else
				face[i]=0;
		}
		frame(face,3);
		resetArray(face);
	}
}
void testLeds2()
{
	char face[MSGSIZE];
	resetArray(face);

	for(int j=0;j<96;j++)
	{
		face[j]=255;
		frame(face,3);
		resetArray(face);
	}
}
void testMotors()
{
	char face[MSGSIZE];
	resetArray(face);

	for(int i=96;i<MSGSIZE;i++)
	{
		face[i]=255;
		frame(face,2);
	}
}

// Emotions
void anger(int n, int r)      
{
	char face[MSGSIZE];
	resetArray(face);
	int w=20; //intensidad del led

	if(n==0)
	{
		face[50]=w;
		face[53]=w;
		face[56]=w;
		face[59]=w;
		face[62]=w;
		face[65]=w;

		face[32]=w;
		face[35]=w;
		face[38]=w;
		face[41]=w;
		face[44]=w;
		face[47]=w;

		//motors
		face[95+9]=192;   //motor 9
		frame(face,1);
	}

	if(n==1)               //anger 1
	{
		for(;r>0;r--)
		{
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
				face[70-3*j]=0;
				face[25+3*j]=0;
				face[10-3*j]=0;
				frame(face,2);
			}
		}
	}
}//fin happiness

void eyebrow()
{
	char face[MSGSIZE];
	resetArray(face);

	for(int j=5;j>0;j--)
	{
		face[95+9] = 128;
		frame(face,2);
		face[95+9] = 0;
		frame(face,2);
	}


	frame(face,2);
}
