uchile-robotics-graveyard/uchile_embedded/head_boards_http/MPLABXProjects/ejemplos/emociones/PicUSB.c

#include <18F4550.h>
#DEVICE ADC=8
#fuses HSPLL,NOWDT,NOPROTECT,NOLVP,NODEBUG,USBDIV,PLL5,CPUDIV1,VREGEN
#use delay(clock=48000000)

#define USB_HID_DEVICE     FALSE             //deshabilitamos el uso de las directivas HID
#define USB_EP1_TX_ENABLE  USB_ENABLE_BULK   //turn on EP1(EndPoint1) for IN bulk/interrupt transfers
#define USB_EP1_RX_ENABLE  USB_ENABLE_BULK   //turn on EP1(EndPoint1) for OUT bulk/interrupt transfers
#define USB_EP1_TX_SIZE    1                 //size to allocate for the tx endpoint 1 buffer
#define USB_EP1_RX_SIZE    3                 //size to allocate for the rx endpoint 1 buffer

//Microchip PIC18Fxx5x Hardware layer for CCS's PIC USB driver
#include <pic18_usb.h>
#include <PicUSB.h>         //Configuración del USB y los descriptores para este dispositivo
#include <usb.c>           //handles usb setup tokens and get descriptor reports

#define MAX(A,B) ((A)>(B))? ((A):(B))
#define MIN(A,B) ((A)<(B))? ((A):(B))

//Declaración puerto serial

#define RAND_MAX 10
#include <stdlib.h>
#include <usb_bootloader.h>
#define LAT_B PIN_D5

//funciones
void emocion(int arreglo[], int delay); //(arreglo de 96)
void resetear(int arreglo[]);
//Emociones
void sadness(int n, int r); //n=nivel; r=repetición 
void anger(int n, int r);
void happiness(int n, int r);
void shamed(int n, int r);
void surprise(int n, int r);
void standby(int n, int r);

//declaracion de variables
int cara[96];

//CICLO PRINCIPAL
void main(void)
{
   output_high(PIN_D4);     //en_b
   output_low(PIN_B0);    //rst_b 
   setup_spi(spi_master |spi_l_to_h |spi_clk_div_16 ); // inicializa el SPI, definido como master, low to high, 16 bit
  
   output_high(LAT_B); // pin correspondiente al LAT_B
   delay_us(1);
   output_low(LAT_B);
   
   setup_ccp1(CCP_PWM);
   setup_timer_2(T2_DIV_BY_1, 8, 1);
   set_pwm1_duty(4);
   
   output_high(PIN_D6);    //sel_bk 
//pruebas

resetear(cara);
//emocion(cara,500);
//anger(1,5);
//delay_ms(1000);
//anger(2,5);
//delay_ms(1000);
//anger(3,5);
//resetear(cara);
//emocion(cara,500);

//delay_ms(2000);
//sadness(1,3);
//delay_ms(1000);
//sadness(2,7);
//delay_ms(1000);
//sadness(3,7);
//delay_ms(1000);
//shamed(1,5);
//delay_ms(1500);
//resetear(cara);
//standby(1,3);
//delay_ms(1500);
//resetear(cara);
//surprise(1,5);
//delay_ms(1500);
//resetear(cara);
//happiness(1,5);
//delay_ms(1500);
//resetear(cara);
//happiness(2,5);
//delay_ms(1500);
//resetear(cara);
happiness(3,5);

} //fin main
//funciones auxiliares
void emocion(int arreglo[], int delay)
{
   int i; 
   for(i=0;i<96;i++)
   {
      spi_write(arreglo[i]);
   }  
   output_high(LAT_B); // pin correspondiente al LAT_B
   delay_us(1000);
   output_low(LAT_B);
   output_low(PIN_D4);     //en_b
   delay_ms(delay);  //delay en segundos
}
void resetear(int arreglo[])
{
   int j; 
    for(j=0;j<96;j++) //resetea el arreglo para iniciar la emocion
    {
       arreglo[j]=0;
    }
}
//funciones: emociones
void anger(int n, int r)      
{
 int w;
 int j;
     w=15;
 resetear(cara); 
 if(n==1)               //anger 1
 {
  while(r>0,r--)
  {
   for(j=0;j<6;j++)      //frame 1
   {
   w=w+5;
      cara[2]=w;
      cara[50]=w;
      cara[53]=w;
      cara[56]=w;
      cara[41]=w;
      cara[44]=w;
      cara[47]=w;
      cara[95]=w;
      cara[26]=w;
      cara[29]=w;
      cara[68]=w;
      cara[71]=w;
   emocion(cara,100);
   }  
   for(j=0;j<6;j++)      //frame 2
   {
   w=w-5;
      cara[2]=w;
      cara[50]=w;
      cara[53]=w;
      cara[56]=w;
      cara[41]=w;
      cara[44]=w;
      cara[47]=w;
      cara[95]=w;
      cara[26]=w;
      cara[29]=w;
      cara[68]=w;
      cara[71]=w;
   emocion(cara,100);
   }
   resetear(cara); 
  }
 } //fin if(n==1)
 if(n==2)               //anger 2
 {
  while(r>0,r--)
  {
   for(j=0;j<2;j++)      //frame 1
   {
   w=w+10;
      cara[2]=w;
      cara[50]=w;
      cara[53]=w;
      cara[56]=w;
      cara[41]=w;
      cara[44]=w;
      cara[47]=w;
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
   cara[55]=w;
   cara[58]=w;
   cara[52]=w;
   cara[43]=w;
   cara[37]=w;
   cara[40]=w;
   cara[49]=w;
   cara[46]=w;
  for(j=0;j<2;j++)
   {
   cara[94]=0;
   cara[1]=0;
   cara[91]=0;
   cara[4]=0;
   cara[61]=w;
   cara[34]=w;
   cara[64]=w;
   cara[31]=w;
   emocion(cara,400);
   cara[94]=w;
   cara[1]=w;
   cara[91]=w;
   cara[4]=w;
   cara[61]=0;
   cara[34]=0;
   cara[64]=0;
   cara[31]=0;
   emocion(cara,400);
   }
  }
 }
 if(n==3)           //happy 3
 {
 while(r>0,r--)
  {
      cara[49]=w;
      cara[52]=w;
      cara[55]=w;
      cara[58]=w;
      cara[37]=w;
      cara[40]=w;
      cara[43]=w;
      cara[46]=w;
  for(j=0;j<4;j++)
   {
   cara[94-3*j]=w;
   cara[61+3*j]=w;
   cara[34-3*j]=w;
   cara[1+3*j]=w;
   emocion(cara,400);
   }
   for(j=0;j<4;j++)
   {
   cara[85+3*j]=0;
   cara[70-3*j]=0;
   cara[25+3*j]=0;
   cara[10-3*j]=0;
   emocion(cara,400);
   }
  }
 }
}//fin happiness
