uchile-robotics-graveyard/uchile_embedded/head_boards_http/MPLABXProjects/ejemplos/i2c/i2c_master_example.c

/**********************************************************************
* NOTES:
* Code uses the Peripheral library support available with MCC18 Compiler
* Code Tested on:
* PicDem2+ demo board with PIC18F4685 controller
*
* SCA & SCL must be connected to the corresponding in slave
*Note: If not using PicDem2+ demo board, then SCA & SCL lines have to be pulled up by
connecting 4.7KOhms resister to Vdd.
**********************************************************************/
#define USE_OR_MASKS
#include <p18cxxx.h>
#include "i2c.h"
unsigned char I2C_Send[21] = "MICROCHIP:I2C_MASTER" ;
unsigned char I2C_Recv[21];
//************ I2C MASTER ****************************
void main(void)
{
unsigned char sync_mode=0, slew=0, add1,w,data,status,length;
for(w=0;w<20;w++)
I2C_Recv[w]=0;
add1=0xA2; //address of the device (slave) under communication
CloseI2C(); //close i2c if was operating earlier
//---INITIALISE THE I2C MODULE FOR MASTER MODE WITH 100KHz ---
sync_mode = MASTER;
slew = SLEW_OFF;
OpenI2C(sync_mode,slew);
SSPADD=0x0A; //400kHz Baud clock(9) @8MHz
//check for bus idle condition in multi master communication
IdleI2C();
//---START I2C---
StartI2C();
//****write the address of the device for communication***
data = SSPBUF; //read any previous stored content in buffer to clear buffer full
status
do
{
status = WriteI2C( add1 | 0x00 ); //write the address of slave
if(status == -1) //check if bus collision happened
{
data = SSPBUF; //upon bus collision detection clear the buffer,
SSPCON1bits.WCOL=0; // clear the bus collision status bit
}
}
while(status!=0); //write untill successful communication
//R/W BIT IS '0' FOR FURTHER WRITE TO SLAVE
//***WRITE THE THE DATA TO BE SENT FOR SLAVE***
while(putsI2C(I2C_Send)!=0); //write string of data to be transmitted to slave
//---TERMINATE COMMUNICATION FROM MASTER SIDE---
IdleI2C();
//---RESTART I2C COMMUNICATION---
RestartI2C();
IdleI2C();
//***write the address of the device for communication***
data = SSPBUF; //read any previous stored content in buffer to clear buffer
full status
//R/W BIT IS '1' FOR READ FROM SLAVE
add1 = 0xA2;
do
{
status = WriteI2C( add1 | 0x01 ); //write the address of slave
if(status == -1) //check if bus collision happened
{
data = SSPBUF; //upon bus collision detection clear the buffer,
SSPCON1bits.WCOL=0; // clear the bus collision status bit
}
}
while(status!=0); //write untill successful communication
//*** Recieve data from slave ***
while( getsI2C(I2C_Recv,20) ); //recieve data string of lenght 20 from slave
I2C_Recv[20] = '\0' ;
NotAckI2C(); //send the end of transmission signal through nack
while( SSPCON2bits.ACKEN!=0); //wait till ack sequence is complete
//*** close I2C ***
CloseI2C(); //close I2C module
while(1); //End of program
}
