uchile-robotics-graveyard/uchile_embedded/(commit log)

2016-01-29 head controller
    [head_led_driver.X.production.obj, l.obj]
2016-02-21 Código de placas para cabeza nueva, basadas en comunicación HTTP
    [bender_head.brd, bender_head.sch, ethernet_board.brd, ethernet_board.sch, num_leds_rgb.xlsx, servo_driver_board.brd, servo_driver_board.sch]
2016-07-05 Version ROS fuerte de bender_head_Arduino
2016-07-26 Agrego capas de Abstracción
2016-07-31 Agrego lista de colores
2016-08-26 Actualizo tareas pendientes y agrego cmd para joystick
2016-09-18 Fix issues with new version of Dynamixel library
    [head_driver_fix.ino]
